YuviniVelasquez/line_detecting_mcu_motorized_vehicle/images/courseexecution86.jpg

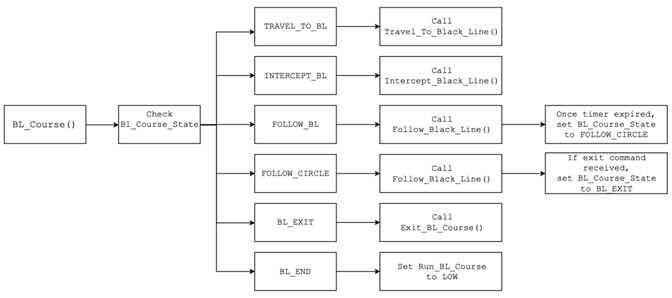
images/courseexecution86.jpg
