YuviniVelasquez/line_detecting_mcu_motorized_vehicle/images/IMG_5401.jpg

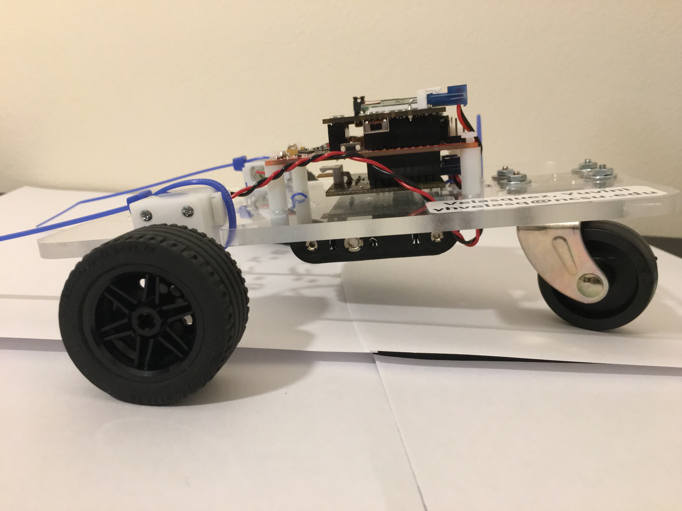
images/IMG_5401.jpg
