YuviniVelasquez/line_detecting_mcu_motorized_vehicle/images/interrupts83.jpg

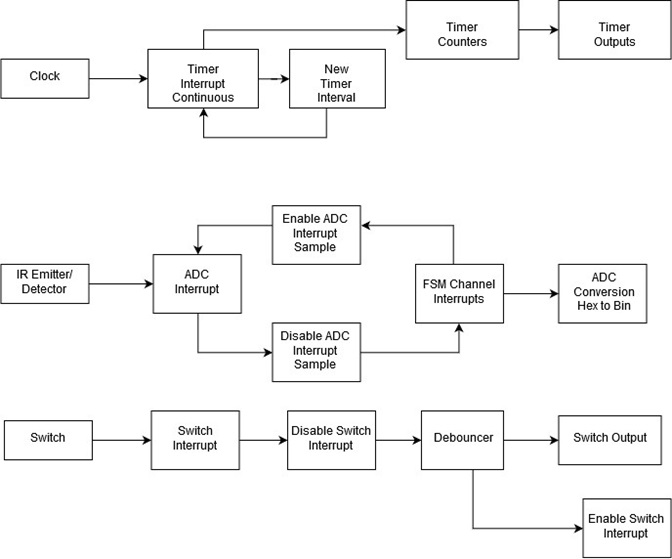
images/interrupts83.jpg
