YuviniVelasquez/line_detecting_mcu_motorized_vehicle/images/interrupts832.jpg

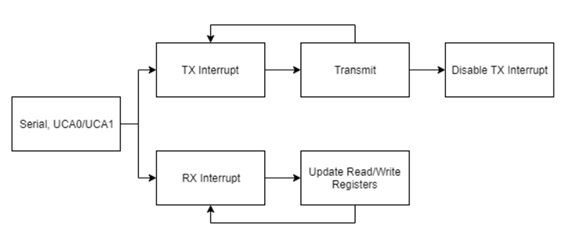
images/interrupts832.jpg
