YuviniVelasquez/line_detecting_mcu_motorized_vehicle/images/interrupts833.jpg

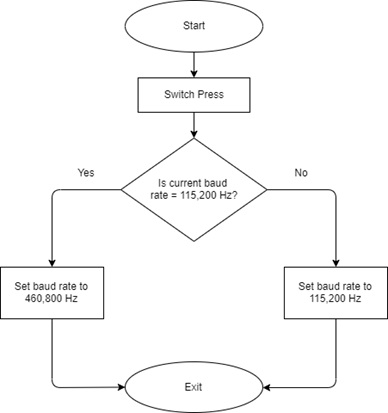
images/interrupts833.jpg
