YuviniVelasquez/line_detecting_mcu_motorized_vehicle/images/iot46.jpg

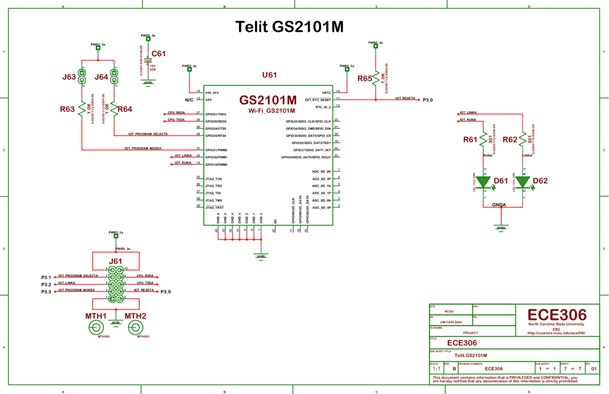
images/iot46.jpg
