YuviniVelasquez/line_detecting_mcu_motorized_vehicle/images/iotconfig841.jpg

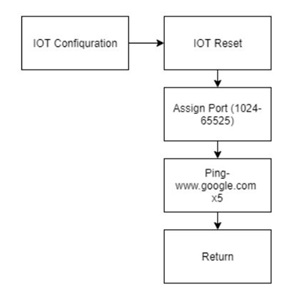
images/iotconfig841.jpg
