YuviniVelasquez/line_detecting_mcu_motorized_vehicle/images/iotconfig842.jpg

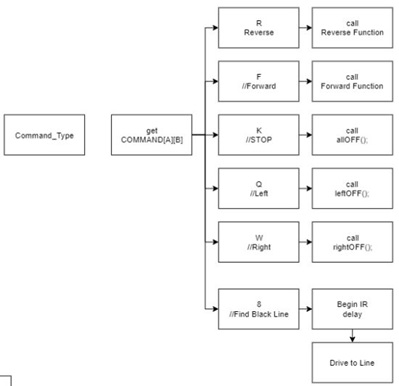
images/iotconfig842.jpg
