YuviniVelasquez/line_detecting_mcu_motorized_vehicle/images/iotconfig843.jpg

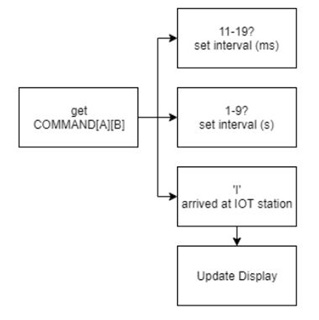
images/iotconfig843.jpg
