YuviniVelasquez/line_detecting_mcu_motorized_vehicle/images/ir44.jpg

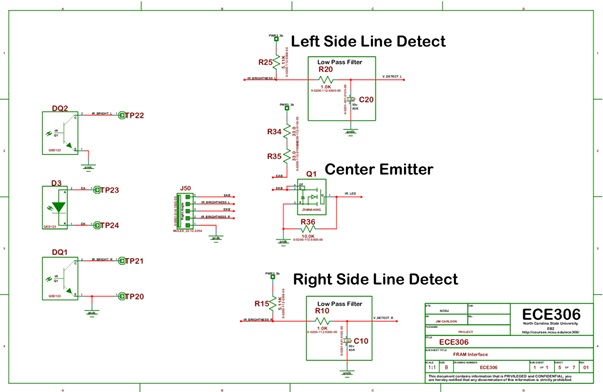
images/ir44.jpg
