YuviniVelasquez/line_detecting_mcu_motorized_vehicle/images/lcd43.jpg

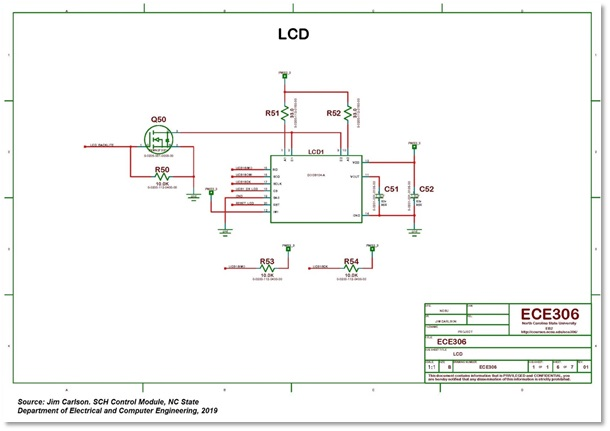
images/lcd43.jpg
