YuviniVelasquez/line_detecting_mcu_motorized_vehicle/images/main81.jpg

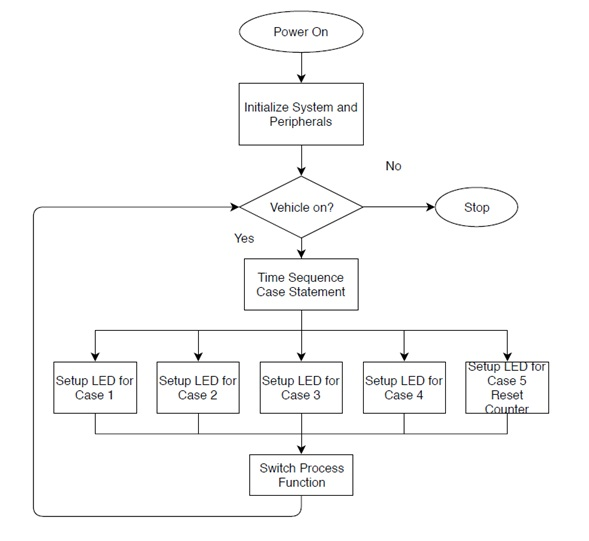
images/main81.jpg
