YuviniVelasquez/line_detecting_mcu_motorized_vehicle/images/motors42.jpg

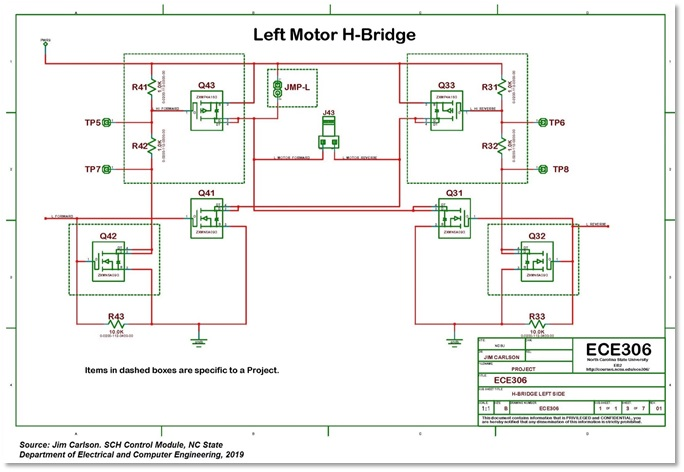
images/motors42.jpg
