YuviniVelasquez/line_detecting_mcu_motorized_vehicle/images/motorsr42.jpg

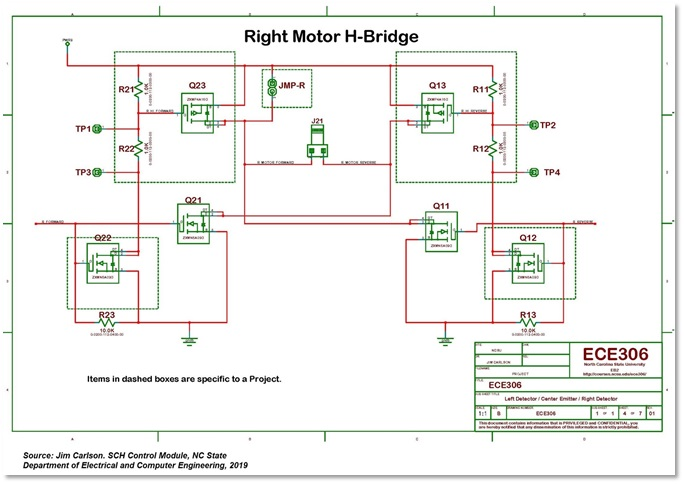
images/motorsr42.jpg
