YuviniVelasquez/line_detecting_mcu_motorized_vehicle/images/portinit822.jpg

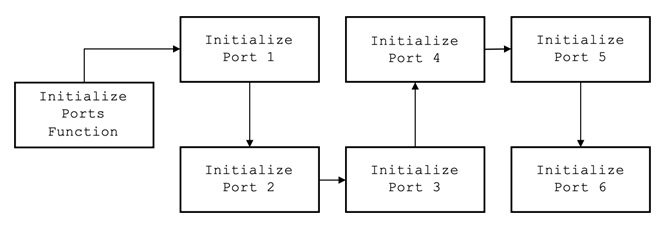
images/portinit822.jpg
