YuviniVelasquez/line_detecting_mcu_motorized_vehicle/images/powersystem41.jpg

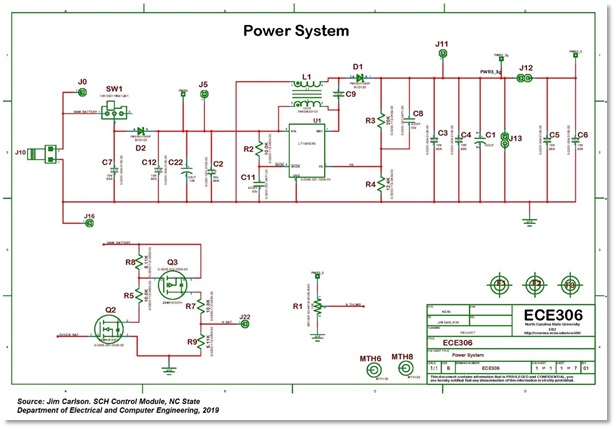
images/powersystem41.jpg
