YuviniVelasquez/line_detecting_mcu_motorized_vehicle/images/serial45.jpg

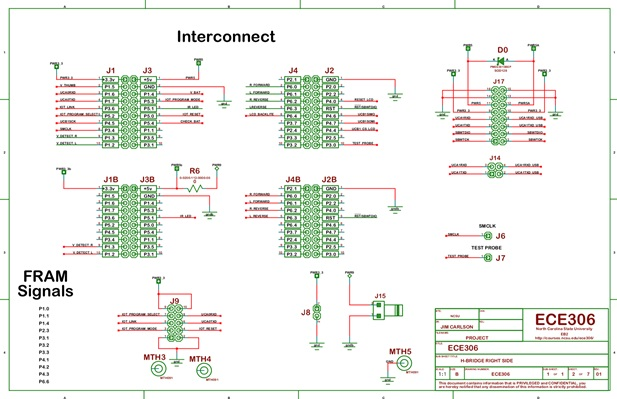
images/serial45.jpg
