YuviniVelasquez/line_detecting_mcu_motorized_vehicle/images/serialinit823.jpg

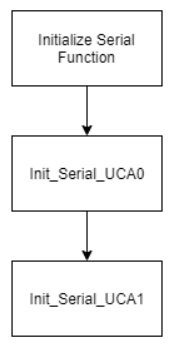
images/serialinit823.jpg
