YuviniVelasquez/line_detecting_mcu_motorized_vehicle/images/timerinit821.jpg

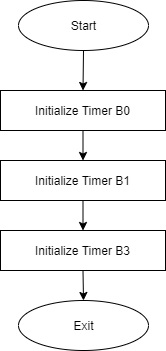
images/timerinit821.jpg
