YuviniVelasquez/line_detecting_mcu_motorized_vehicle/images/transmitsignal85.jpg

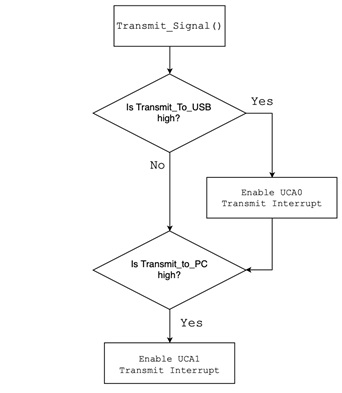
images/transmitsignal85.jpg
